aimanharithah03/EV-DynoLogger-Project/DynoLogger Dashboard/Dashboard 1.jpg

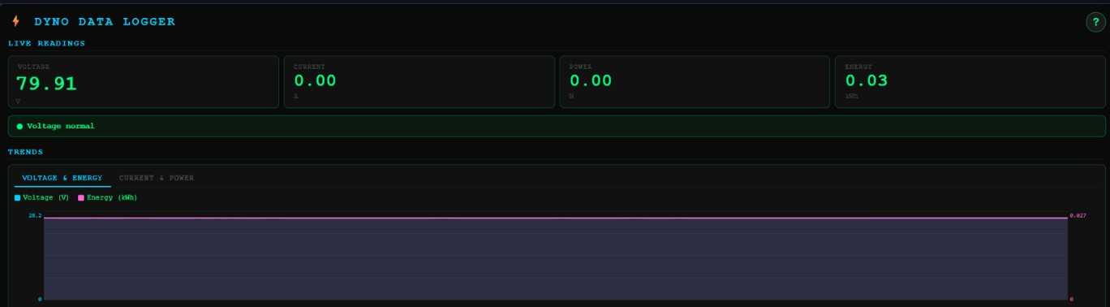
DynoLogger Dashboard/Dashboard 1.jpg
