aimanharithah03/EV-DynoLogger-Project/DynoLogger Dashboard/Dashboard 2.jpg.png

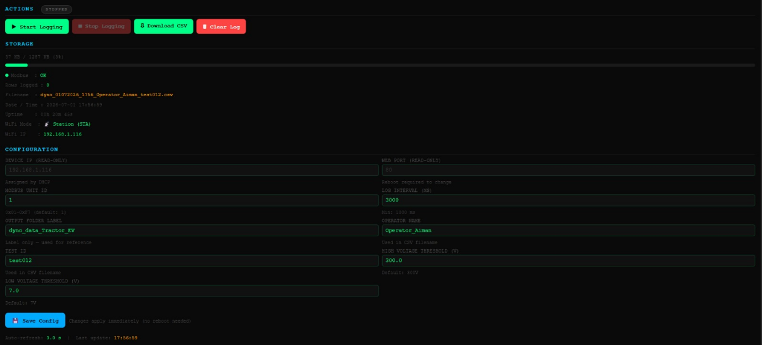
DynoLogger Dashboard/Dashboard 2.jpg.png
