aimanharithah03/EV-DynoLogger-Project/DynoLogger Dashboard/Dashboard 3.jpg.png

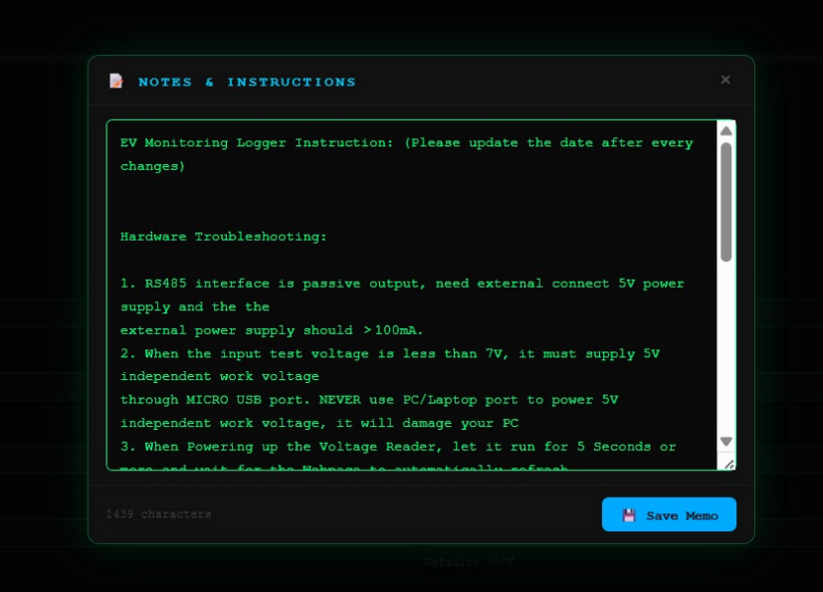
DynoLogger Dashboard/Dashboard 3.jpg.png
